jacobmealey/capstone/hardware/models/assembly.FCStd

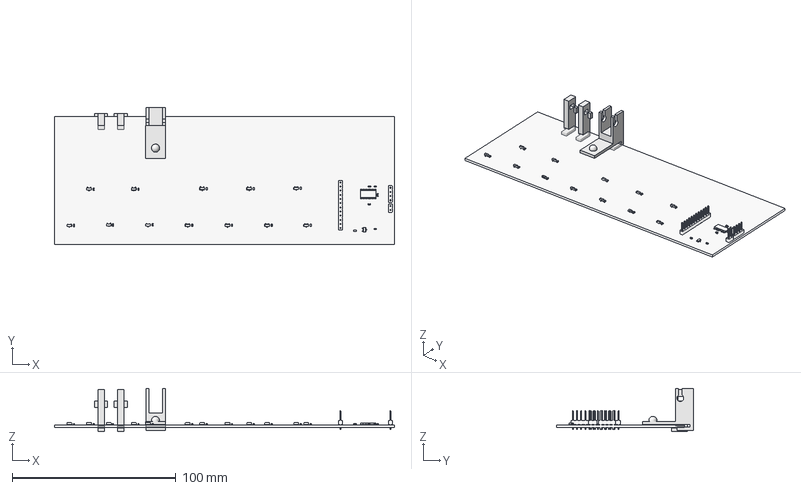
[picture p1: CAD file, 2022-12-01]
hardware/models/assembly.FCStd
207.5 x 83.5 x 26.2 mm
developmentboard
key_mount-Body
key_mount-Body001
