jacobmealey/capstone/hardware/STL/widekey_littleassembly.FCStd

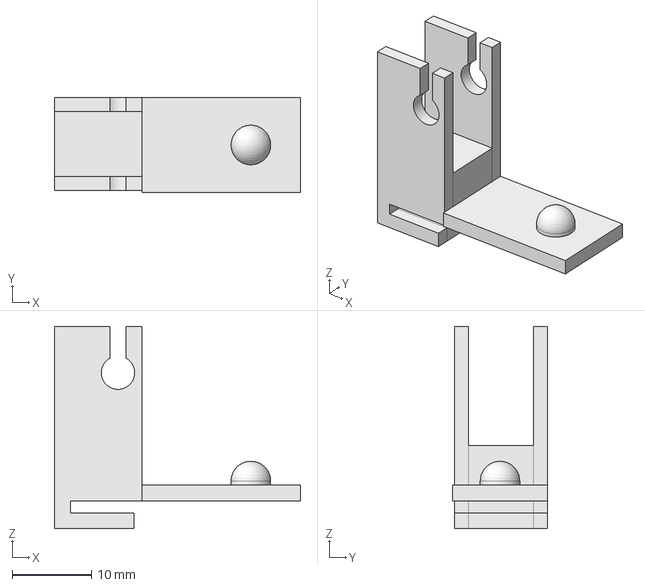
[picture p2: CAD file, 2022-12-01]
hardware/STL/widekey_littleassembly.FCStd
31.0 x 12.0 x 25.5 mm
