jacobmealey/capstone/hardware/STL/key_1-AssemblyFillet.stl

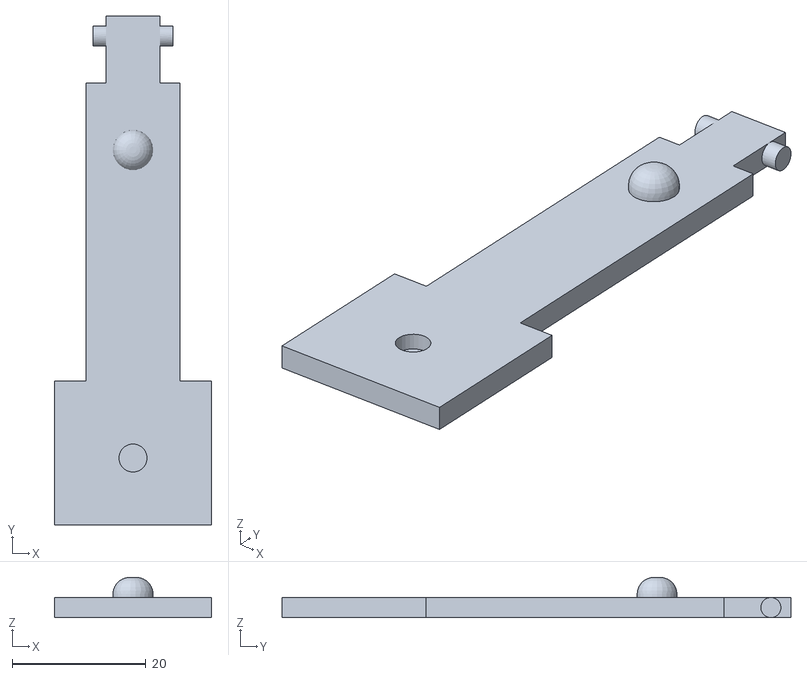
[picture p3: CAD file, 2022-08-15]
hardware/STL/key_1-AssemblyFillet.stl
23.5 x 76.0 x 6.00
