jacobmealey/capstone/hardware/models/key_2.FCStd

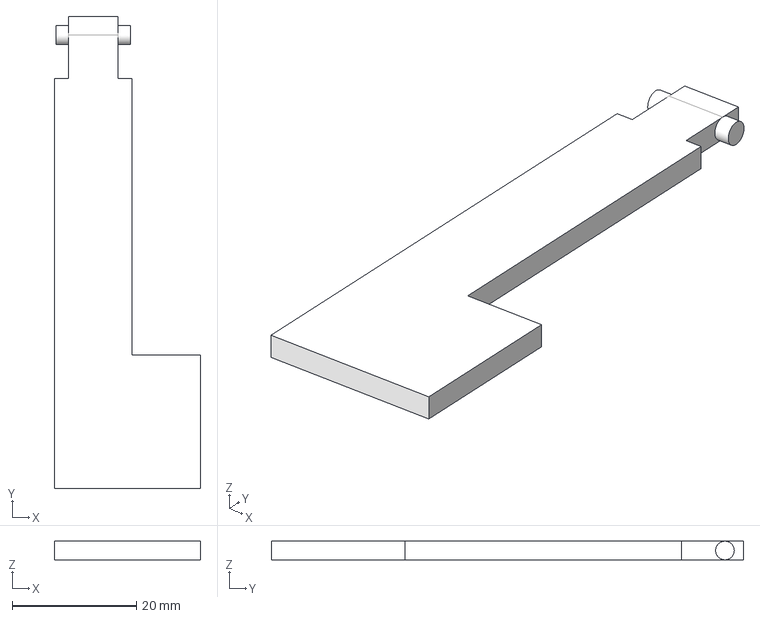
[picture p4: CAD file, 2022-12-01]
hardware/models/key_2.FCStd
23.5 x 76.0 x 3.00 mm
