jacobmealey/capstone/hardware/models/key_spring_mount.FCStd

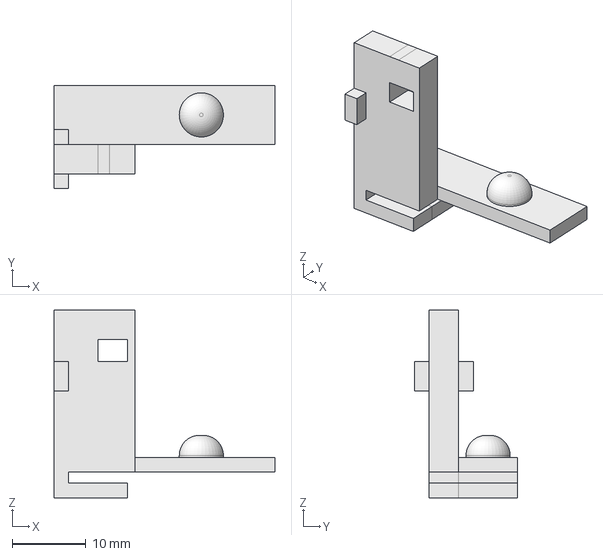
[picture p5: CAD file, 2022-11-03]
hardware/models/key_spring_mount.FCStd
30.0 x 14.0 x 25.5 mm
