jacobmealey/capstone/hardware/models/key_black.FCStd

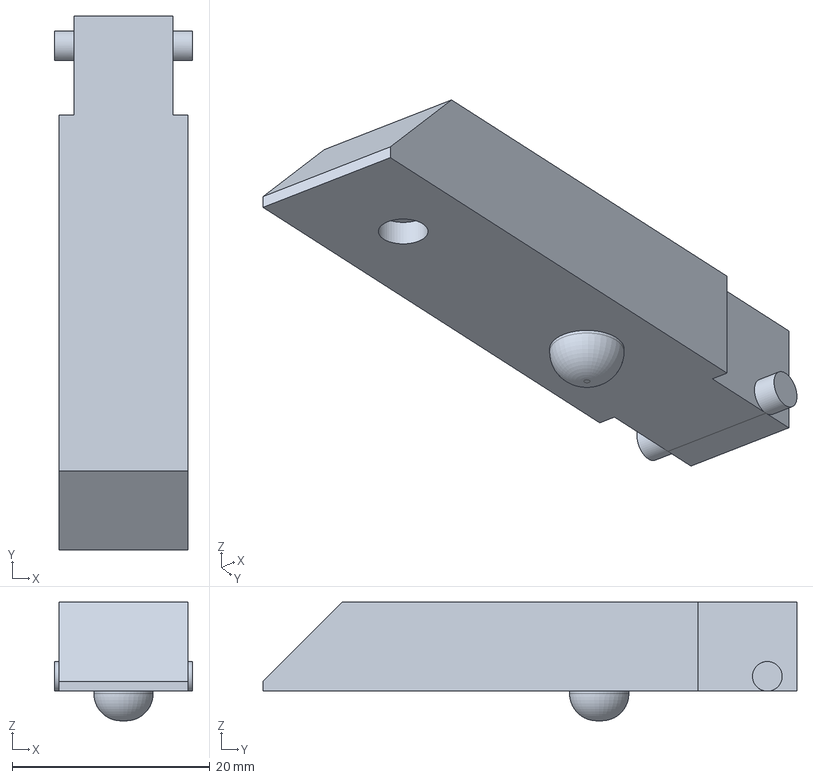
[picture p6: CAD file, 2022-11-03]
hardware/models/key_black.FCStd
14.0 x 54.0 x 12.0 mm
