jacobmealey/capstone/hardware/models/key_3A.FCStd

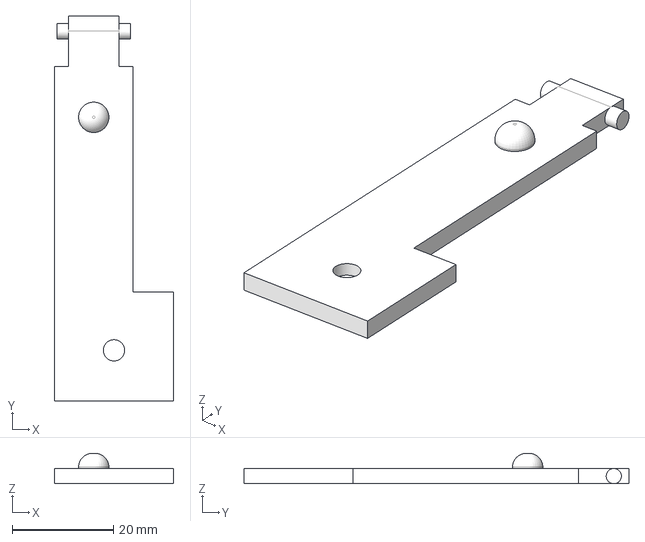
[picture p7: CAD file, 2022-08-15]
hardware/models/key_3A.FCStd
23.5 x 76.0 x 6.00 mm
