jacobmealey/capstone/hardware/models/key_1A.FCStd

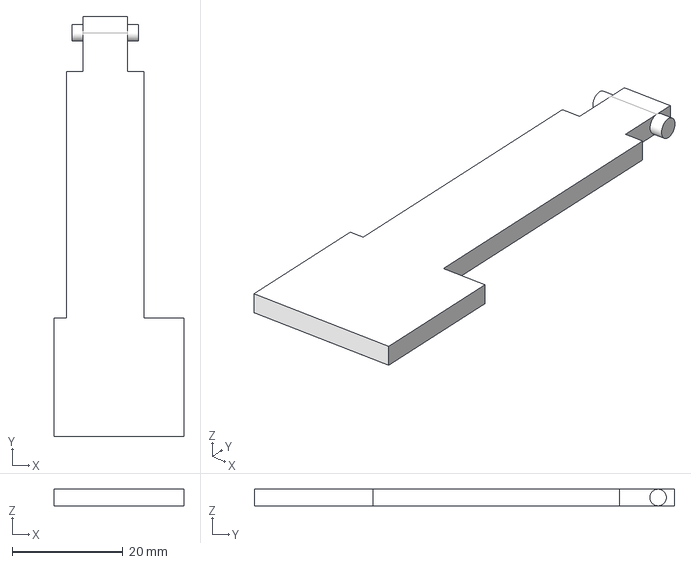
[picture p8: CAD file, 2022-08-15]
hardware/models/key_1A.FCStd
23.5 x 76.0 x 3.00 mm
