jacobmealey/capstone/hardware/STL/key_and_spring.stl

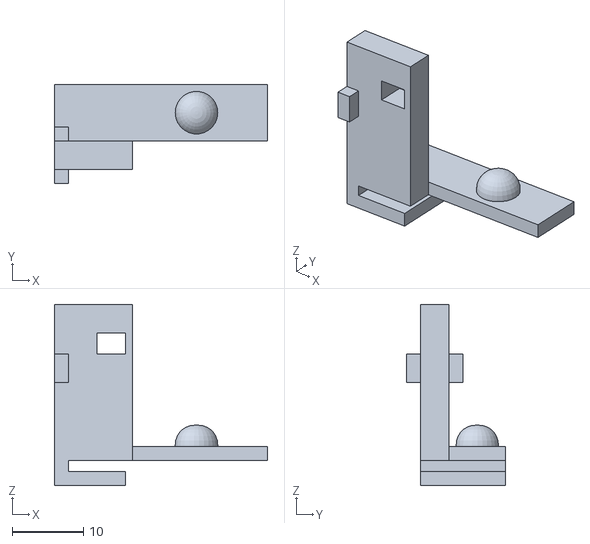
[picture p9: CAD file, 2022-11-03]
hardware/STL/key_and_spring.stl
30.0 x 14.0 x 25.5
