jacobmealey/capstone/hardware/STL/spring_mount-BodyFillet.stl

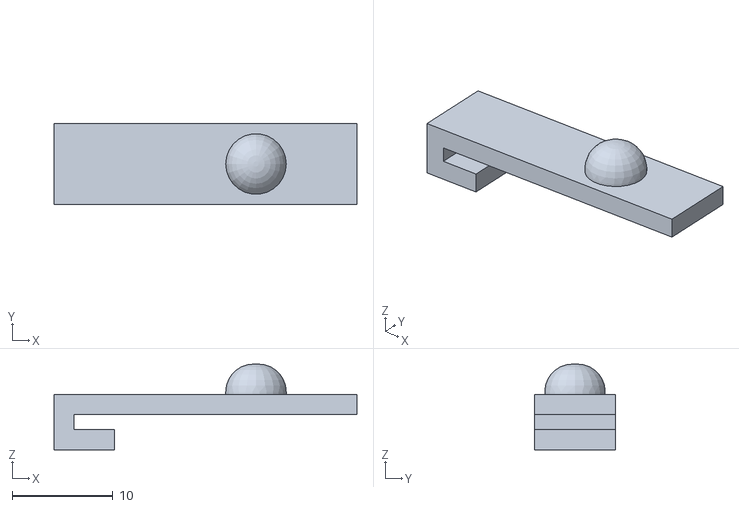
[picture p10: CAD file, 2022-08-15]
hardware/STL/spring_mount-BodyFillet.stl
30.0 x 8.00 x 8.50
