jacobmealey/capstone/hardware/models/key_3.FCStd

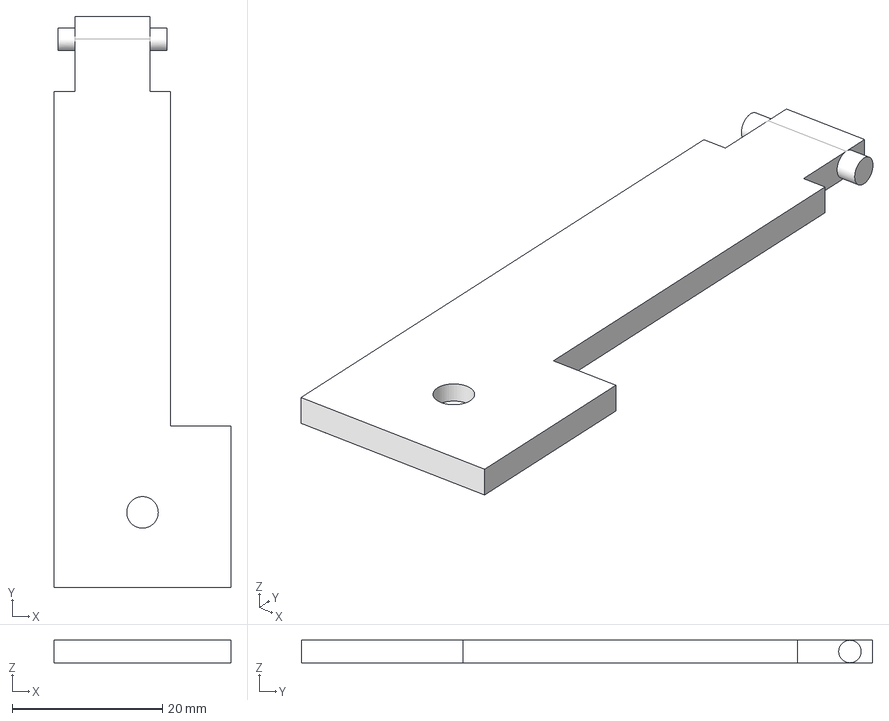
[picture p11: CAD file, 2022-08-15]
hardware/models/key_3.FCStd
23.5 x 76.0 x 3.00 mm
