jacobmealey/capstone/hardware/STL/key_mount-Body.stl

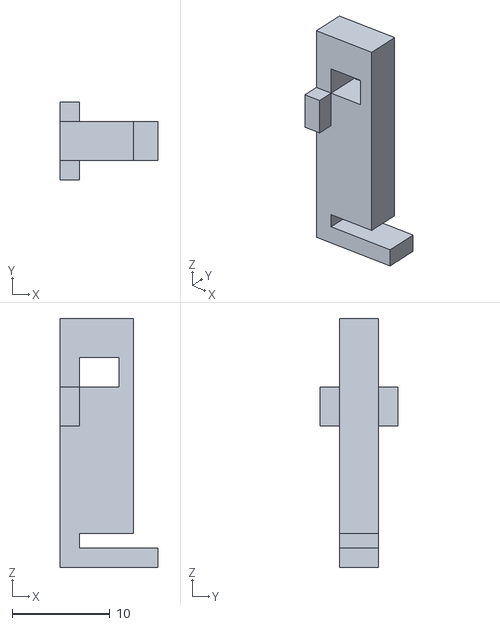
[picture p12: CAD file, 2022-08-15]
hardware/STL/key_mount-Body.stl
10.0 x 8.00 x 25.5
