jacobmealey/capstone/hardware/STL/key_2Bstl.stl

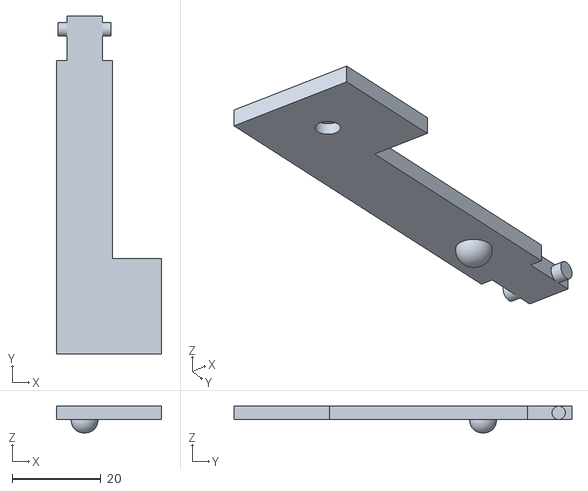
[picture p13: CAD file, 2022-08-15]
hardware/STL/key_2Bstl.stl
23.5 x 76.0 x 6.00
