jacobmealey/capstone/(list of files, cad)

Other CAD files:
hardware/STL/littleassembly.FCStd
hardware/STL/spring_mount-BodyFillet_wide.stl
hardware/STL/keyv2.stl
hardware/STL/keyspringmount_v2.stl
hardware/models/key_1A_A.FCStd
hardware/STL/key_black-key_black.stl
hardware/models/key_1.FCStd
hardware/models/key_3B.FCStd
hardware/models/key_2B.FCStd
hardware/models/key_2A.FCStd
hardware/models/key_mount.FCStd
hardware/models/spring_mount.FCStd
hardware/models/key_1A_B.FCStd
hardware/STL/key_1A_A.stl
hardware/STL/key_1A_B.stl
hardware/STL/key_2A.stl
hardware/STL/key_3A.stl
hardware/STL/key_3B.stl
hardware/STL/widekey_littleassembly.stl
hardware/models/key_and_spring.stl
