jacobmealey/capstone/hardware/powerboard/powerboard.kicad_pcb

## KiCad design hardware/powerboard/powerboard.kicad_pcb (2022-12-05)

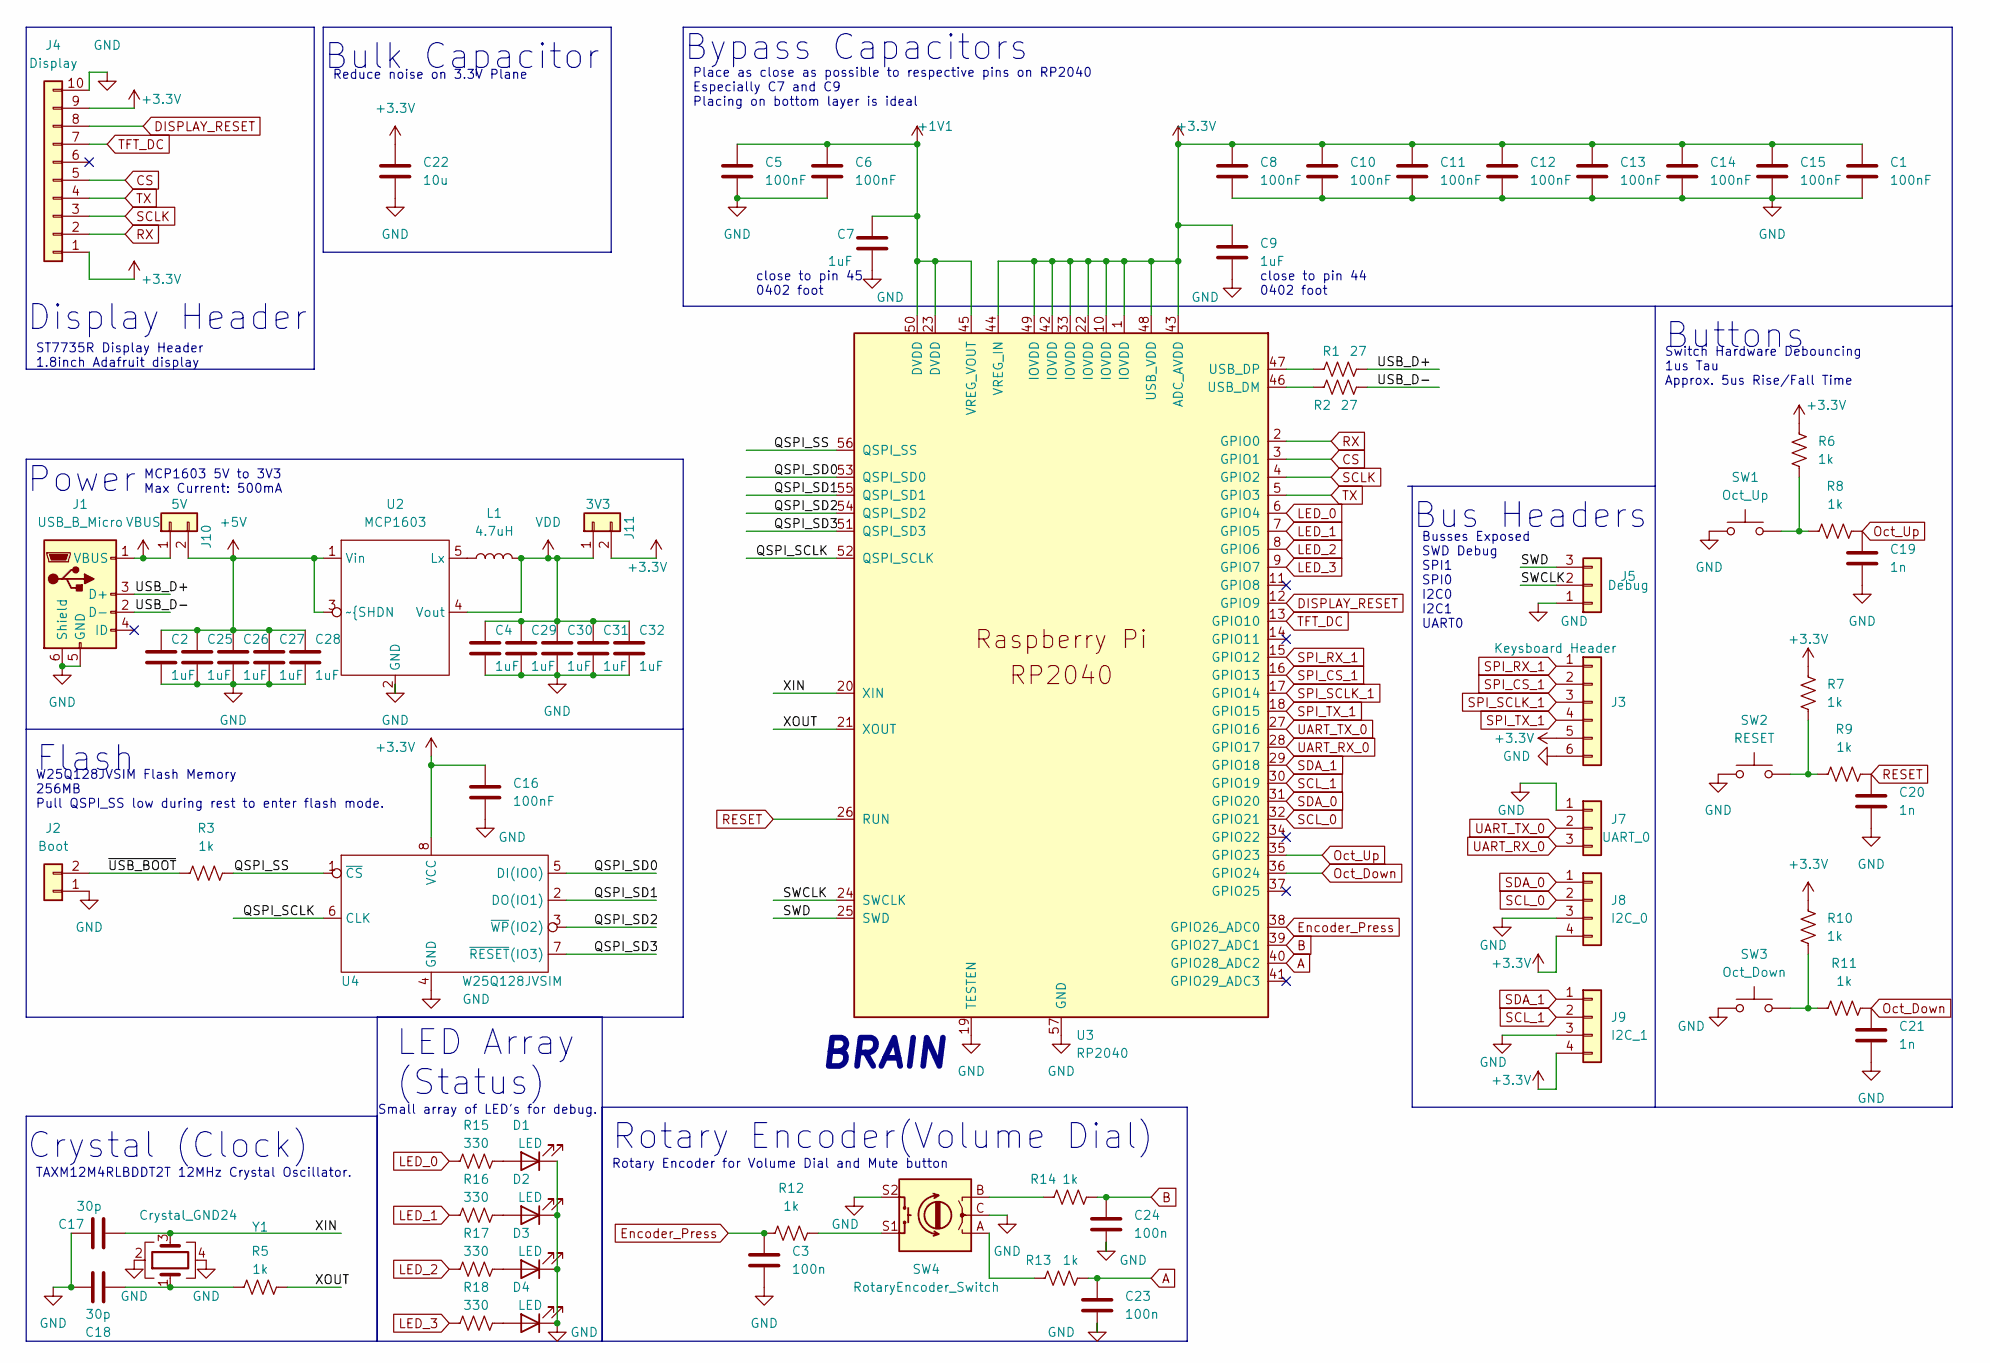
[picture p14: schematic powerboard.kicad_sch, MIDI Keyboard: Brain Board]

Parts:
C1, C5, C6, C8, C10, C11, C12, C13, C14, C15: 100nF; C_0402_1005Metric; LCSC C307331
C2, C4, C25, C26, C27, C28, C29, C30, C31, C32: 1uF; C_0805_2012Metric; LCSC C28323
C3, C23, C24: 100n; C_0402_1005Metric; LCSC C307331
C7, C9: 1uF; C_0402_1005Metric; LCSC C307413
C16: 100nF; C_0603_1608Metric; LCSC C307331
C17, C18: 30p; C_0603_1608Metric; LCSC C1658
C19, C20, C21: 1n; C_0603_1608Metric; LCSC C1588
C22: 10u; C_0805_2012Metric; LCSC C440198
D1, D2, D3, D4: LED; LED_0603_1608Metric; LCSC C87326
J1: USB_B_Micro; USB_Micro-B_Amphenol_10118194_Horizontal; LCSC C132563
J2: Boot; PinHeader_1x02_P2.54mm_Vertical; LCSC C2905434
J3: Keysboard Header; PinSocket_1x06_P2.54mm_Horizontal; LCSC C2932681
J4: Display; PinSocket_1x10_P2.54mm_Vertical; LCSC C2905418
J5: Debug; PinHeader_1x03_P2.54mm_Vertical; LCSC C2932698
J7: UART_0; PinHeader_1x03_P2.54mm_Vertical; LCSC C2932698
J8: I2C_0; PinHeader_1x04_P2.54mm_Vertical; LCSC C2905435
J9: I2C_1; PinHeader_1x04_P2.54mm_Vertical; LCSC C2905435
J10: 5V; PinHeader_1x02_P2.54mm_Vertical; LCSC C2905434
J11: 3V3; PinHeader_1x02_P2.54mm_Vertical; LCSC C2905434
L1: 4.7uH; L_1812_4532Metric; LCSC C701275
R1, R2: 27; R_0402_1005Metric; LCSC C25100
R3, R5, R6, R7, R8, R9, R10, R11, R12, R13, R14: 1k; R_0603_1608Metric; LCSC C21190
R15, R16, R17, R18: 330; R_0603_1608Metric; LCSC C23138
SW1: Oct_Up; SW_PUSH_6mm; LCSC C428628
SW2: RESET; SW_PUSH_6mm; LCSC C428628
SW3: Oct_Down; SW_PUSH_6mm; LCSC C428628
SW4: RotaryEncoder_Switch; RotaryEncoder_Alps_EC11E-Switch_Vertical_H20mm; LCSC C278348
U2: MCP1603; TSOT-23-5; LCSC C150803
U3: RP2040; RP2040-QFN-56; LCSC C9900024873
U4: W25Q128JVSIM; SOIC-8W_5.3x5.3mm_P1.27mm; LCSC C2613930
Y1: Crystal_GND24; Crystal_SMD_3225-4Pin_3.2x2.5mm; LCSC C133334

Connections:
+1V1: C5.1, C6.1, C7.1, U3.23 (DVDD), U3.45 (VREG_VOUT), U3.50 (DVDD)
+3.3V: C1.1, C8.1, C9.1, C10.1, C11.1, C12.1, C13.1, C14.1, C15.1, C16.1, C22.1, J3.5, J4.1, J4.9, J8.4, J9.4, J11.2, R6.1, R7.1, R10.1, U3.1 (IOVDD), U3.10 (IOVDD), U3.22 (IOVDD), U3.33 (IOVDD), U3.42 (IOVDD), U3.43 (ADC_AVDD), U3.44 (VREG_IN), U3.48 (USB_VDD), U3.49 (IOVDD), U4.8 (VCC)
+5V: C2.1, C25.1, C26.1, C27.1, C28.1, J10.2, U2.1 (Vin), U2.3 (~{SHDN)
/QSPI_SCLK: U3.52 (QSPI_SCLK), U4.6 (CLK)
/QSPI_SD0: U3.53 (QSPI_SD0), U4.5 (DI(IO0))
/QSPI_SD1: U3.55 (QSPI_SD1), U4.2 (DO(IO1))
/QSPI_SD2: U3.54 (QSPI_SD2), U4.3 (~WP(IO2))
/QSPI_SD3: U3.51 (QSPI_SD3), U4.7 (~RESET(IO3))
/QSPI_SS: R3.2, U3.56 (QSPI_SS), U4.1 (~CS)
/SWCLK: J5.2, U3.24 (SWCLK)
/SWD: J5.3, U3.25 (SWD)
/USB_D+: J1.3 (D+), R1.2
/USB_D-: J1.2 (D-), R2.2
/XIN: C17.2, U3.20 (XIN), Y1.3
/XOUT: R5.2, U3.21 (XOUT)
/~USB_BOOT: J2.2, R3.1
A: C23.1, R13.2, U3.40 (GPIO28_ADC2)
B: C24.1, R14.2, U3.39 (GPIO27_ADC1)
CS: J4.5, U3.3 (GPIO1)
DISPLAY_RESET: J4.8, U3.12 (GPIO9)
Encoder_Press: C3.1, R12.1, U3.38 (GPIO26_ADC0)
GND: C1.2, C2.2, C3.2, C4.2, C5.2, C6.2, C7.2, C8.2, C9.2, C10.2, C11.2, C12.2, C13.2, C14.2, C15.2, C16.2, C17.1, C18.1, C19.2, C20.2, C21.2, C22.2, C23.2, C24.2, C25.2, C26.2, C27.2, C28.2, C29.2, C30.2, C31.2, C32.2, D1.1 (K), D2.1 (K), D3.1 (K), D4.1 (K), J1.5 (GND), J1.6 (Shield), J2.1, J3.6, J4.10, J5.1, J7.1, J8.3, J9.3, SW1.1, SW2.1, SW3.1, SW4.C, SW4.S2, U2.2 (GND), U3.19 (TESTEN), U3.57 (GND), U4.4 (GND), Y1.2, Y1.4
LED_0: R15.1, U3.6 (GPIO4)
LED_1: R16.1, U3.7 (GPIO5)
LED_2: R17.1, U3.8 (GPIO6)
LED_3: R18.1, U3.9 (GPIO7)
unnamed: C18.2, R5.1, Y1.1
unnamed: D1.2 (A), R15.2
unnamed: D2.2 (A), R16.2
unnamed: D3.2 (A), R17.2
unnamed: D4.2 (A), R18.2
unnamed: L1.1, U2.5 (Lx)
unnamed: R1.1, U3.47 (USB_DP)
unnamed: R2.1, U3.46 (USB_DM)
unnamed: R6.2, R8.1, SW1.2
unnamed: R7.2, R9.1, SW2.2
unnamed: R10.2, R11.1, SW3.2
unnamed: R12.2, SW4.S1
unnamed: R13.1, SW4.A
unnamed: R14.1, SW4.B
Oct_Down: C21.1, R11.2, U3.36 (GPIO24)
Oct_Up: C19.1, R8.2, U3.35 (GPIO23)
RESET: C20.1, R9.2, U3.26 (RUN)
RX: J4.2, U3.2 (GPIO0)
SCLK: J4.3, U3.4 (GPIO2)
SCL_0: J8.2, U3.32 (GPIO21)
SCL_1: J9.2, U3.30 (GPIO19)
SDA_0: J8.1, U3.31 (GPIO20)
SDA_1: J9.1, U3.29 (GPIO18)
SPI_CS_1: J3.2, U3.16 (GPIO13)
SPI_RX_1: J3.1, U3.15 (GPIO12)
SPI_SCLK_1: J3.3, U3.17 (GPIO14)
SPI_TX_1: J3.4, U3.18 (GPIO15)
TFT_DC: J4.7, U3.13 (GPIO10)
TX: J4.4, U3.5 (GPIO3)
UART_RX_0: J7.3, U3.28 (GPIO17)
UART_TX_0: J7.2, U3.27 (GPIO16)
VBUS: J1.1 (VBUS), J10.1
VDD: C4.1, C29.1, C30.1, C31.1, C32.1, J11.1, L1.2, U2.4 (Vout)

Notes on the sheet:
Power
Busses Exposed SWD Debug SPI1 SPI0 I2C0 I2C1 UART0
Small array of LED's for debug.
W25Q128JVSIM Flash Memory 256MB Pull QSPI_SS low during rest to enter flash mode.
Bus Headers
Rotary Encoder for Volume Dial and Mute button
Buttons
Flash
Display Header
LED Array (Status)
Bypass Capacitors
BRAIN
TAXM12M4RLBDDT2T 12MHz Crystal Oscillator.
Crystal (Clock)
close to pin 44 0402 foot
Bulk Capacitor
close to pin 45 0402 foot
Place as close as possible to respective pins on RP2040 Especially C7 and C9 Placing on bottom layer is ideal
MCP1603 5V to 3V3 Max Current: 500mA
Reduce noise on 3.3V Plane
ST7735R Display Header 1.8inch Adafruit display
Rotary Encoder(Volume Dial)
Switch Hardware Debouncing 1us Tau Approx. 5us Rise/Fall Time

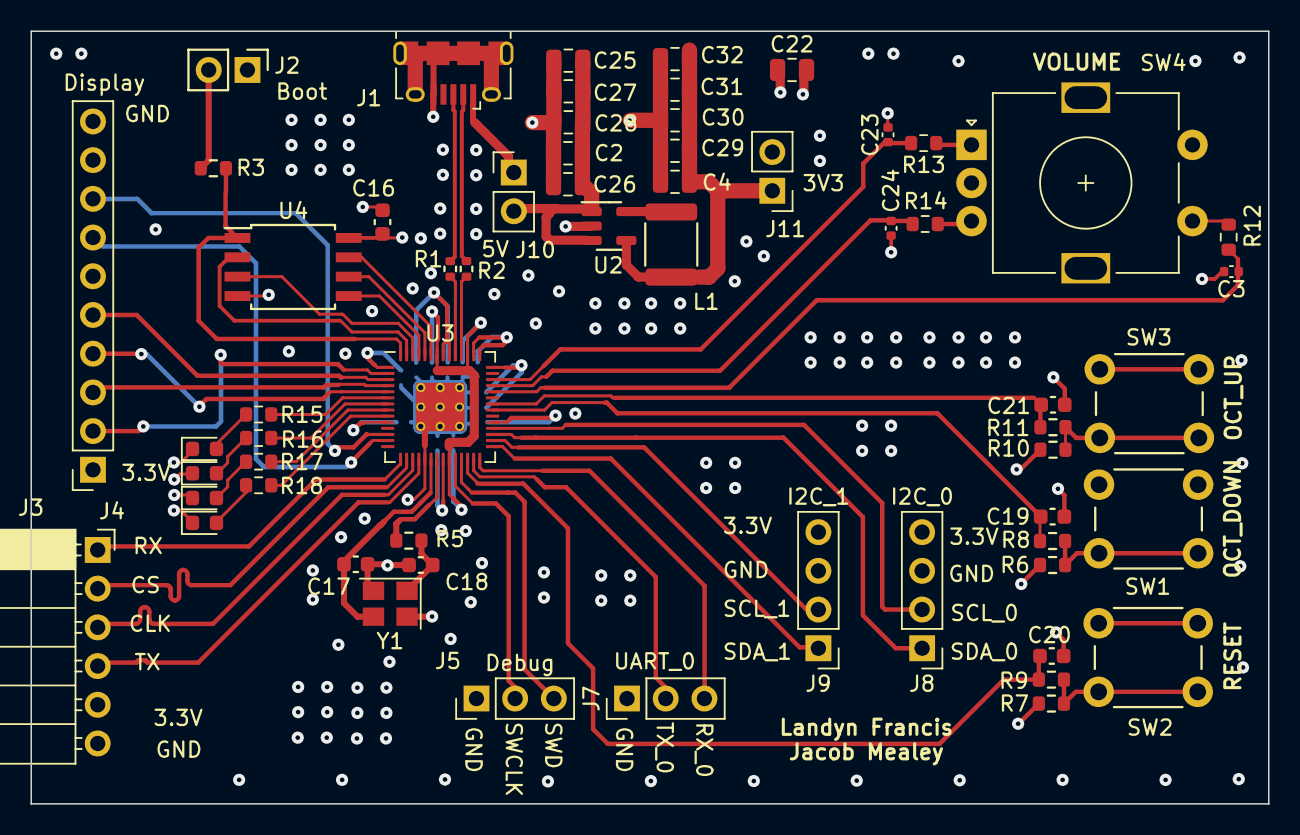
[picture p15: board powerboard.kicad_pcb from above]

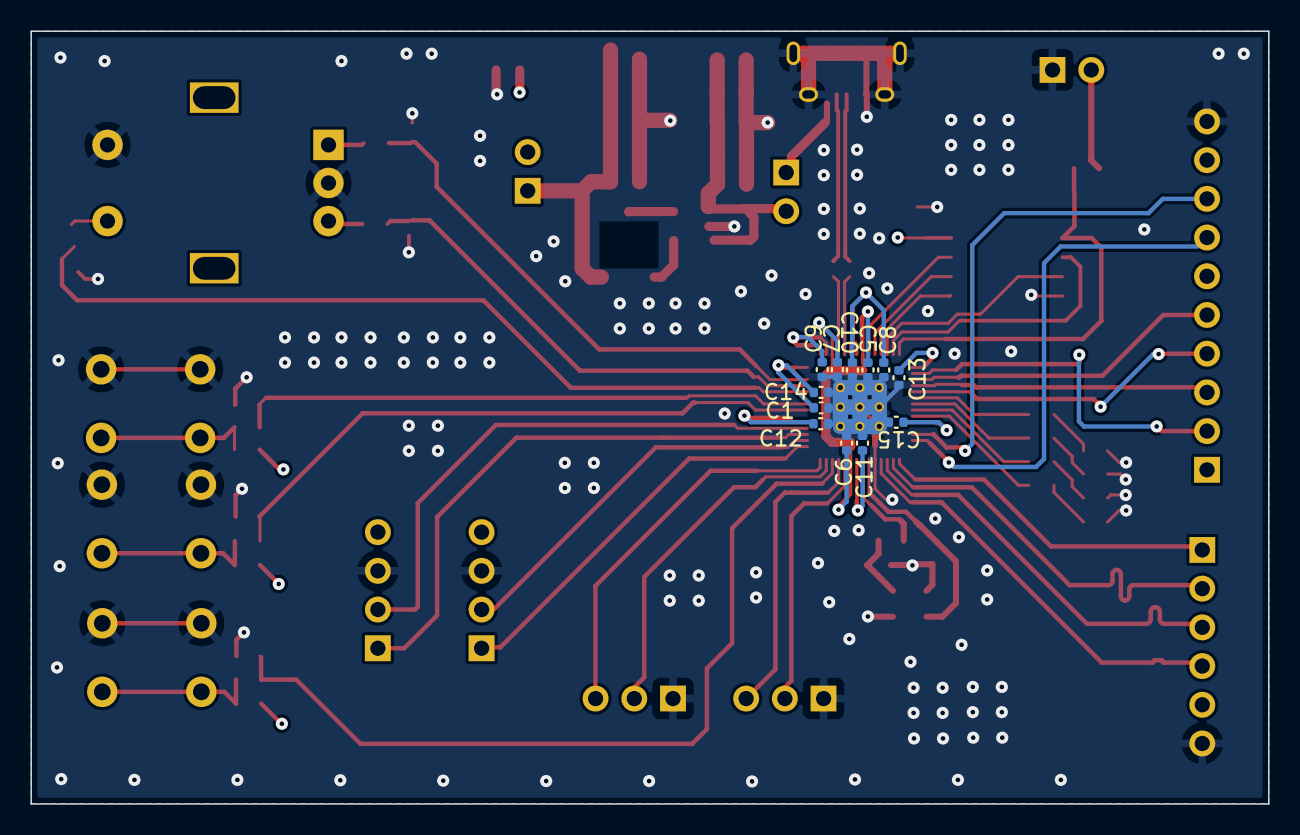
[picture p16: board powerboard.kicad_pcb from below]

Board: 4 copper layers, 81.2 x 50.7 mm, 72 parts (12 on the bottom side), 59 nets.
