jacobmealey/capstone/hardware/developmentboard/developmentboard.kicad_pcb

## KiCad design hardware/developmentboard/developmentboard.kicad_pcb (2022-10-17)

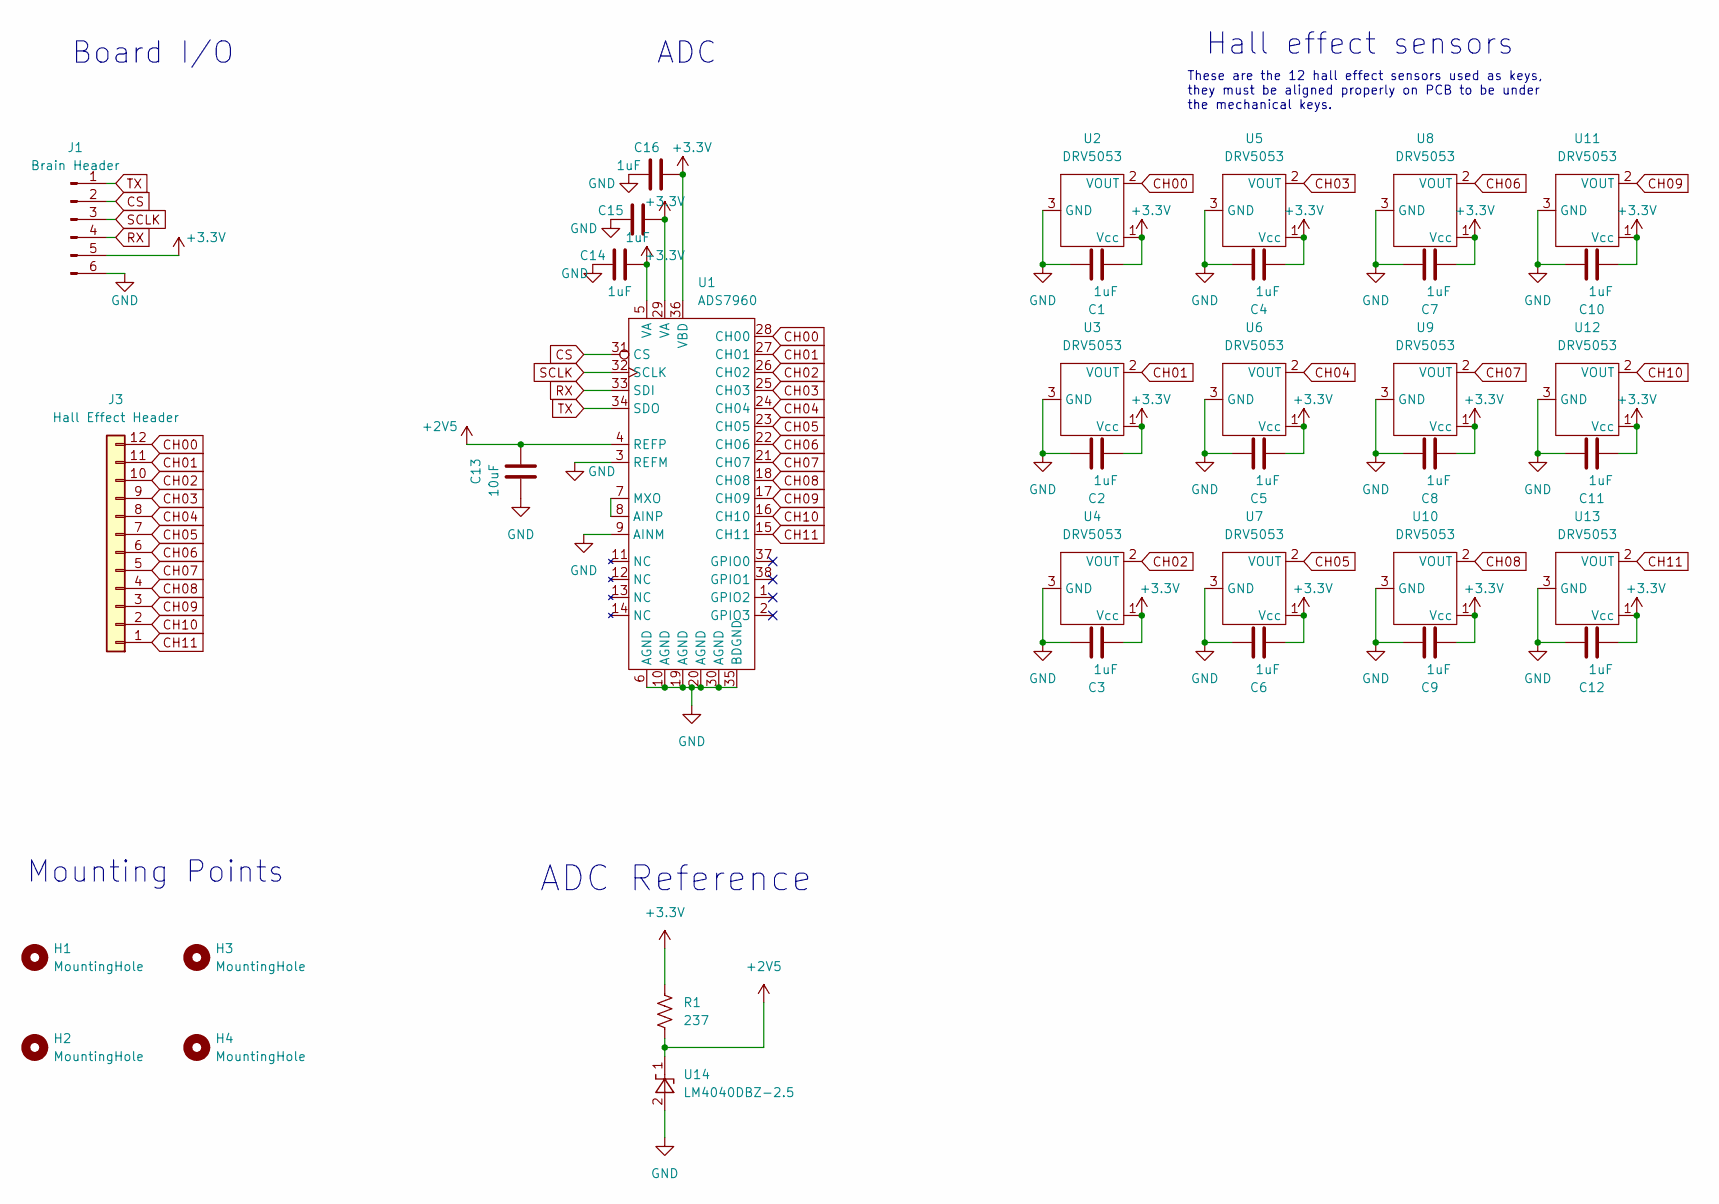
[picture p17: schematic developmentboard.kicad_sch, MIDI Keyboard: Keyboard]

Parts:
C1, C2, C3, C4, C5, C6, C7, C8, C9, C10, C11, C12, C14, C15, C16: 1uF; C_0603_1608Metric; LCSC C90540
C13: 10uF; C_0603_1608Metric; LCSC C96446
H1, H2, H3, H4: MountingHole; MountingHole_4.3mm_M4
J1: Brain Header; PinHeader_1x06_P2.54mm_Vertical; LCSC C2932681
J3: Hall Effect Header; PinHeader_1x12_P2.54mm_Vertical; LCSC C2833334
R1: 237; R_1210_3225Metric; part number CR1210F237RP05Z; LCSC C174455
U1: ADS7960; TSSOP-38_4.4x9.7mm_P0.5mm; LCSC C1543353
U2, U3, U4, U5, U6, U7, U8, U9, U10, U11, U12, U13: DRV5053; SOT-23; LCSC C2866569
U14: LM4040DBZ-2.5; SOT-23; LCSC C134019

Connections:
+2V5: C13.1, R1.2, U1.4 (REFP), U14.1 (K)
+3.3V: C1.2, C2.2, C3.2, C4.2, C5.2, C6.2, C7.2, C8.2, C9.2, C10.2, C11.2, C12.2, C14.2, C15.2, C16.2, J1.5, R1.1, U1.5 (VA), U1.29 (VA), U1.36 (VBD), U2.1 (Vcc), U3.1 (Vcc), U4.1 (Vcc), U5.1 (Vcc), U6.1 (Vcc), U7.1 (Vcc), U8.1 (Vcc), U9.1 (Vcc), U10.1 (Vcc), U11.1 (Vcc), U12.1 (Vcc), U13.1 (Vcc)
CH00: J3.12, U1.28 (CH00), U2.2 (VOUT)
CH01: J3.11, U1.27 (CH01), U3.2 (VOUT)
CH02: J3.10, U1.26 (CH02), U4.2 (VOUT)
CH03: J3.9, U1.25 (CH03), U5.2 (VOUT)
CH04: J3.8, U1.24 (CH04), U6.2 (VOUT)
CH05: J3.7, U1.23 (CH05), U7.2 (VOUT)
CH06: J3.6, U1.22 (CH06), U8.2 (VOUT)
CH07: J3.5, U1.21 (CH07), U9.2 (VOUT)
CH08: J3.4, U1.18 (CH08), U10.2 (VOUT)
CH09: J3.3, U1.17 (CH09), U11.2 (VOUT)
CH10: J3.2, U1.16 (CH10), U12.2 (VOUT)
CH11: J3.1, U1.15 (CH11), U13.2 (VOUT)
CS: J1.2, U1.31 (CS)
GND: C1.1, C2.1, C3.1, C4.1, C5.1, C6.1, C7.1, C8.1, C9.1, C10.1, C11.1, C12.1, C13.2, C14.1, C15.1, C16.1, J1.6, U1.3 (REFM), U1.6 (AGND), U1.9 (AINM), U1.10 (AGND), U1.19 (AGND), U1.20 (AGND), U1.30 (AGND), U1.35 (BDGND), U2.3 (GND), U3.3 (GND), U4.3 (GND), U5.3 (GND), U6.3 (GND), U7.3 (GND), U8.3 (GND), U9.3 (GND), U10.3 (GND), U11.3 (GND), U12.3 (GND), U13.3 (GND), U14.2 (A)
unnamed: U1.7 (MXO), U1.8 (AINP)
RX: J1.4, U1.33 (SDI)
SCLK: J1.3, U1.32 (SCLK)
TX: J1.1, U1.34 (SDO)

Notes on the sheet:
Board I/O
Hall effect sensors
ADC
Mounting Points
ADC Reference
These are the 12 hall effect sensors used as keys, they must be aligned properly on PCB to be under the mechanical keys.

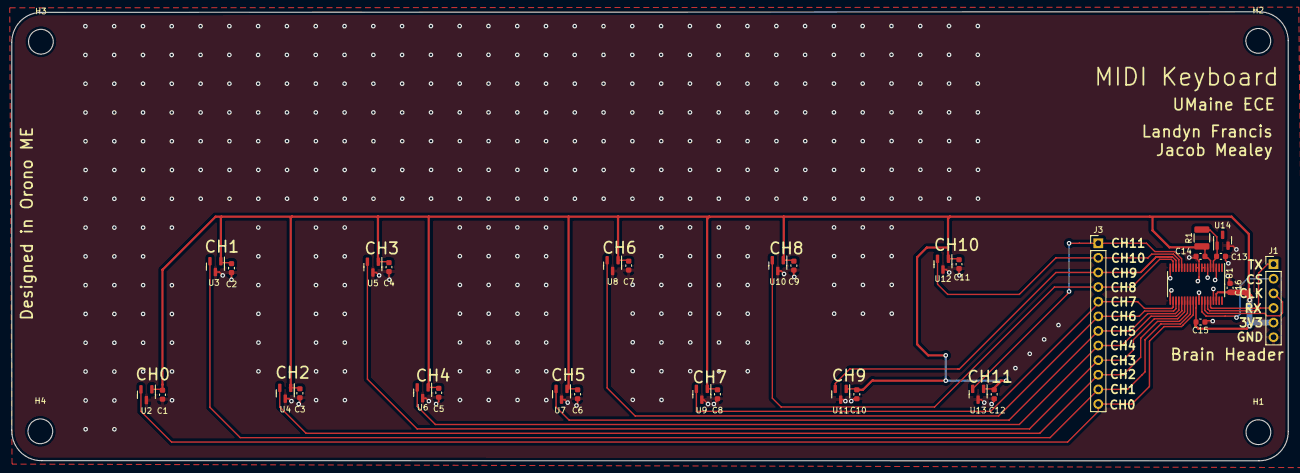
[picture p18: board developmentboard.kicad_pcb from above]

Board: 2 copper layers, 221.8 x 78.0 mm, 37 parts (0 on the bottom side), 20 nets.
