jacobmealey/capstone/software/firmware/midi_velocity_lut.h

#ifndef MIDI_VEL_LUT_H
#define MIDI_VEL_LUT_H

uint8_t midi_velocity_lut[95] = {
	0,
	1,
	2,
	4,
	5,
	6,
	8,
	9,
	10,
	12,
	13,
	14,
	16,
	17,
	18,
	20,
	21,
	22,
	24,
	25,
	26,
	28,
	29,
	30,
	32,
	33,
	34,
	36,
	37,
	38,
	40,
	41,
	42,
	44,
	45,
	46,
	48,
	49,
	50,
	52,
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
};

#endif
