jacobmealey/capstone/(commit log)

2022-07-16 ??? made a board lol
    [developmentboard.kicad_pcb, developmentboard.kicad_sch]
2022-07-22 added 2.5v regulator and 12 keys
    added 2.5v regulator and 12 keys
    added 2.5v regulator and 12 keys
    [developmentboard.kicad_pcb]
2022-07-31 migrated to version 6 made new symbols and included in repo
    [developmentboard.kicad_pcb, developmentboard.kicad_sch]
2022-07-31 made ece library parts relative to project
    forgit sym-lib-table
    [developmentboard.kicad_sch]
2022-07-31 added hall-effect sensor
    [developmentboard.kicad_sch]
2022-07-31 testing gitignore
    [developmentboard.kicad_sch]
2022-08-04 white keys going crazy
    [assembly.FCStd, key_1.FCStd, key_1A.FCStd, key_2.FCStd, key_3.FCStd, key_black.FCStd]
2022-08-04 colored keys finished basic assembly
    [assembly.FCStd, key_1.FCStd, key_1A.FCStd, key_2.FCStd, key_3.FCStd, key_black.FCStd]
2022-08-08 Development Board Schematic Changes
    [developmentboard.kicad_sch]
2022-08-09 3d models lol
    [assembly.FCStd, key_1A.FCStd, key_3.FCStd, key_mount.FCStd]
2022-08-12 Bypassed Va and Vbd to GND with 1uF AINM to GND Breakout pins for ADC pins
    [developmentboard.kicad_sch]
2022-08-15 finalized touches on keyyys + new key mounting
    finalized touches on keyyys + new key mounting
    [assembly.FCStd, key_1-AssemblyFillet.stl, key_1.FCStd, key_1A.FCStd, key_1A_A.FCStd, key_1A_A.stl, key_1A_B.FCStd, key_1A_B.stl]
2022-08-22 Powerboard schematic started
    [powerboard.kicad_pcb, powerboard.kicad_sch]
2022-08-26 scaffolding for pico project
2022-08-31 initial work for SPI ADC
2022-09-05 basic SPI working -- need to setup with DMA and timers
2022-09-07 Slight schematic changes
    [powerboard.kicad_sch]
2022-09-08 Schematic Headers Added, Footprints Updated
    [developmentboard.kicad_sch, powerboard.kicad_sch]
2022-09-09 Schematics updated, Layout started for powerboard
    [powerboard.kicad_pcb, powerboard.kicad_sch]
2022-09-09 Footprint library taken from RP2040 Minimal
2022-09-10 Powerboard PCB Started
    Powerboard PCB Started
    Placed and Routed Power Section, USB Port, Power Header, All Bypass Capacitors, USB Data Lines.
    [powerboard.kicad_pcb, powerboard.kicad_sch]
2022-09-11 More PCB Layout
    Board Overhauled
    Crystal Routed
    Bypass Caps on Bottom of Board
    Everything but switches done
    ANNULAR RING PROBLEM
    [powerboard.kicad_pcb, powerboard.kicad_sch]
2022-09-12 Power PCB: Everything(?!) Placed
    Added SPI_0 and SPI_1 Headers, for ADC and Display
    Added I2C_0 and I2C_1 Headers, for possible future peripherals, and/or 4 GPIO Pins.
    I assume we don't need UART for anything, so I left it un-routed.
    Everything placed I hope(?), just need to route the buttons and adjust copper zones.
    [powerboard.kicad_pcb, powerboard.kicad_sch]
2022-09-12 timer trigger spi write -- need interrupt for recieve
2022-09-12 added irq for receiving spi data
2022-09-12 PCB Adjustments
    [powerboard.kicad_pcb, powerboard.kicad_sch]
2022-09-12 Added global adc pointer to be shared among everything
2022-09-12 USB Header Footprint Changed
    Found a USB Header on JLCAssembly that has a matching footprint in KiCad, W
    [powerboard.kicad_pcb, powerboard.kicad_sch]
2022-09-13 manually looping through all channels! + uart for printing. need to get auto modes programmed in!
2022-09-13 auto mode 2 working correctly, cleaned up from last few days in hell
    [adc.c, adc.h]
2022-09-14 Power Board PCB: UART, LED's Smaller Crystal
    Replaced Old Crystal with 3N12000G33YC
    Added UART_0 with GP16 and GP17
    Added 4 LED's with 330OHM Resistors on GP4-GP7
    SPI Trace Widths 11.55 mil = 50Ohm Impedance
    [powerboard.kicad_pcb, powerboard.kicad_sch]
2022-09-15 cleaned up developmentboard
    [developmentboard.kicad_sch]
2022-09-15 Initial work on keys pcb
    ADC layout done and inline with the datasheet, and I arranged all the
    hall effect sensors.
    [developmentboard.kicad_pcb]
2022-09-15 Powerboard almsot done, need to finalize Power Circuit design
    [powerboard.kicad_pcb, powerboard.kicad_sch]
2022-09-15 layout for hall effect sensors, imported rules from powerboard
    [developmentboard.kicad_pcb]
2022-09-15 routing for keys and ground fill under adc
    [developmentboard.kicad_pcb]
2022-09-16 Pins.h added Pin assignments setup, SPI pins assigned in main.c
2022-09-16 Same as last commit? VS Code buggin
    [main.c]
2022-09-18 Powerboard changes
    [powerboard.kicad_pcb]
2022-09-18 board outline for developmentboard
    [developmentboard.kicad_pcb]
2022-09-18 fized DRC errors
    [developmentboard.kicad_pcb]
2022-09-18 added more to silkscreen
    [developmentboard.kicad_pcb]
2022-09-18 added more to silkscreen on developmentboard
    [developmentboard.kicad_pcb]
2022-09-19 Updated development board reference circuit
    I threw together a circuit based on the REF5025 datasheet to replace the LDO. This is the chip that is recommended on the ADC datasheet for the reference voltage. Available on JLC as REF5025AIDR
    [developmentboard.kicad_sch]
2022-09-19 added reference IC to PCB, removed LDO
    [assembly.FCStd, developmentboard.kicad_pcb, developmentboard.kicad_sch, key_black.FCStd]
2022-09-19 fixed logic for general_midi_send
    [adc.c, main.c, midi.c, midi.h]
2022-09-19 update adc to spi1 everywhere, fixed pin definitions
    [adc.c, adc.h, main.c, pins.h]
2022-09-19 more work on midi / adc interface
2022-09-20 finalized reference IC pcb stuffs - added footprints for bypass caps
    [developmentboard.kicad_pcb, developmentboard.kicad_sch]
2022-09-21 GPIO Functions done Small footprint changes to powerboard
    [powerboard.kicad_sch]
2022-09-21 Powerboard Renovations (Stage 1 of Finalization)
    Expand SPI 0 Header to match Display Header
    Confirm footprints for passives
    Power Circuit reorganized for short return paths
    Reset button now toggles RUN pin, does not connect to GPIO
    GPIO 10 connected to DISPLAY_RESET pin
    [powerboard.kicad_pcb, powerboard.kicad_sch]
2022-09-21 Power Measurement Headers
    Added, did not connect power measurement headers.
    Do we need these?
    How do we want to measure power?
    This is a high current, high frequency path, can we even do a header like this?
    [powerboard.kicad_sch]
2022-09-22 mounting holes for keys board
    [developmentboard.kicad_pcb]
2022-09-22 Powerboard Finalization
    Crystal Footprint and layout changed to match new crystal
    [powerboard.kicad_pcb, powerboard.kicad_sch]
2022-09-22 Powerboard review with sheaff
    [powerboard.kicad_pcb, powerboard.kicad_sch]
2022-09-22 made development board wider, changed reference voltage to use shunt regulator
    [developmentboard.kicad_pcb, developmentboard.kicad_sch]
2022-09-22 Powerboard PCB Revisions
    Expanded I2C Headers to include 3.3V and GND
    Expanded UART Header to include GND
    Expanded SWD Header to include GND
    Added Silkscreen for All(?) Parts
    Added GND Fill on Back Layer
    Added header for 3.3V and 5V Current Measurements
    Powerboard has all parts picked out and ready to order on JLC
    [powerboard.kicad_pcb, powerboard.kicad_sch]
2022-09-23 more adjustments on powerboard
    [powerboard.kicad_pcb]
2022-09-23 JLC Capabilities Double Checked
    Confirmed JLC Capabilities with Design Rules
    CHECK SILKSCREEN RULES
    [powerboard.kicad_pcb, powerboard.kicad_sch]
2022-09-23 More powerboard finalization
    [powerboard.kicad_pcb]
2022-09-23 Devboard and Powerboard matching headers lined up
    [developmentboard.kicad_pcb]
2022-09-26 MIDI Messages now only sent on Keypress
    [powerboard.kicad_pcb, powerboard.kicad_sch]
2022-09-27 GPIO Added for TFT_DC Display Pin
    Connected GPIO 10 to TFT_DC Pin on Display Header
    DISPLAY_RESET is now Connected to GPIO 9
    pins.h updated accordingly
    [powerboard.kicad_pcb, powerboard.kicad_sch]
2022-09-27 powerboard adjustments, bom added
    [powerboard.csv, powerboard.kicad_pcb, powerboard.kicad_sch]
2022-09-28 Powerboard Output Files Pt.1
    [powerboard.kicad_pcb, powerboard.kicad_sch]
2022-09-29 Tracked gerber files for powerboard
    [powerboard-B_Cu.gbl, powerboard-B_Mask.gbs, powerboard-B_Paste.gbp, powerboard-B_Silkscreen.gbo, powerboard-Edge_Cuts.gm1, powerboard-F_Cu.gtl, powerboard-F_Mask.gts, powerboard-F_Paste.gtp]
2022-09-29 boards board boards no more 3v3 plane and stuwutching
    [developmentboard.kicad_pcb, developmentboard.kicad_sch]
2022-09-29 Gerbers and pick and place generated
    [developmentboard.kicad_sch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]
2022-09-29 Footprint adjusted for W25QJVSIM FLASH
    [powerboard.csv, powerboard.kicad_pcb, powerboard.kicad_sch]
2022-09-29 File Cleanup
    Folder tracking makes me frown
    [powerboard-B_Cu.gbl, powerboard-B_Mask.gbs, powerboard-B_Paste.gbp, powerboard-B_Silkscreen.gbo, powerboard-Edge_Cuts.gm1, powerboard-F_Cu.gtl, powerboard-F_Mask.gts, powerboard-F_Paste.gtp]
2022-09-29 Trying to finalize Powerboard PCB
    JLC is being bitchy about the RP2040 and MCP1603, the parts aren't showing up in the part viewer preview window and they are "unselected" for assembly because "coordinate data cannot be found". Very worrying. but as detailed in my message on Discord, I think I have a solution.
    [powerboard-B_Cu.gbl, powerboard-B_Mask.gbs, powerboard-B_Paste.gbp, powerboard-B_Silkscreen.gbo, powerboard-Edge_Cuts.gm1, powerboard-F_Cu.gtl, powerboard-F_Mask.gts, powerboard-F_Paste.gtp]
2022-09-30 reworked things on develpoment
    [developmentboard.kicad_pcb, developmentboard.kicad_sch]
2022-10-03 GND Vias and RP2040 Footprint change
    When JLC was acting weird, I changed the footprint of the RP2040 to the generic version without thermal vias. I now want the thermal vias again, as they provide an easy GND connection for the chip.
    [powerboard.kicad_pcb, powerboard.kicad_sch]
2022-10-03 RP2040 Footprint Reset - See last commit
    [developmentboard-B_Cu.gbl, developmentboard-B_Mask.gbs, developmentboard-B_Paste.gbp, developmentboard-B_Silkscreen.gbo, developmentboard-Edge_Cuts.gm1, developmentboard-F_Cu.gtl, developmentboard-F_Mask.gts, developmentboard-F_Paste.gtp]
2022-10-05 Key current and prev values should be setup?
    [developmentboard-B_Cu.gbl, developmentboard-B_Mask.gbs, developmentboard-B_Paste.gbp, developmentboard-B_Silkscreen.gbo, developmentboard-Edge_Cuts.gm1, developmentboard-F_Cu.gtl, developmentboard-F_Mask.gts, developmentboard-F_Paste.gtp]
2022-10-05 changed speed of SPI
2022-10-06 working on ADC and Key integration.
2022-10-06 BIG UPDATE ADC now runs at 200kHz ADC Timer reduced to 60ms No more multi note on's when holding key down MIDI Velocity calculated, currently (49-123) range read_irq() function adjusted Probably need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
2022-10-12 Starting work on Rotary Encoder
2022-10-12 Rotary Encoder GPIO Code almost works... Interrupts are making it weird...
2022-10-12 Rotary Encoder logic should be correct. I think the A and B lines are bouncy Getting multiple interrupts on a single falling edge. Software debouncing not working...
    [gpio.c]
2022-10-13 Powerboard Tweaks
    Removed unnecessary header pin vias (lol)
    Adjusted traces
    Cleaned up Bypass Capacitor traces and vias on RP2040
    [powerboard.kicad_pcb]
2022-10-13 Still experiencing double interrupts on A and B lines Sometimes on other lines too, but not as bad... Debouncing hardware didn't fix the problem, definitely seems to be a software issue.
    [gpio.c, midi.c]
2022-10-13 Powerboard Fixes
    Rotary Encoder debouncing hardware fixed (it used to just be a pull up resistor and bypass cap, lol)
    Spaced out GPIO lines as best as I could.
    [powerboard.kicad_pcb, powerboard.kicad_sch]
2022-10-13 THICK TRACES
    I went through and replaced 0.2mm traces with 0.293mm traces, for a few reasons.
    1) Thicker = More current, just in case.
    2) This 0.293mm value is impedance matched for 50Ohms (Phil's Lab Video said it's generally a good idea)
    I also gave the power section very very thick traces. I figured why not, it's high frequency stuff, might as well have good thick traces.
    Still passes DRC
    [powerboard.kicad_pcb]
2022-10-13 THICKY TRACES
    THICK BOY TRACES GO BRRRRR
    [powerboard.kicad_pcb]
2022-10-14 Last Thicky Update
    More thickening
    [powerboard.kicad_pcb]
2022-10-14 3.3V Header Fix
    Both sides of the 3.3V header were on the same +3.3V net, this means that the copper fill on Layer 3 would have connected the header, not the jumper we plan to use. This would have likely broken one of our multimeters if we left it unchanged, and would make power measurements near impossible. The new power net on the output of the DCDC converter is VDD, which goes to one side of the 3.3V pin header, and the +3.3V net is on the other side.
    [powerboard.kicad_pcb, powerboard.kicad_sch]
2022-10-14 More trace spacing
    [powerboard.kicad_pcb]
2022-10-17 output file changes AND notes! Octave is now limited between 9 2 which corresponds to a piano range of C8 to C1, there are 3 notes below C1, that we will not be able to produce.
    [developmentboard-B_Cu.gbl, developmentboard-B_Mask.gbs, developmentboard-B_Paste.gbp, developmentboard-B_Silkscreen.gbo, developmentboard-Edge_Cuts.gm1, developmentboard-F_Cu.gtl, developmentboard-F_Mask.gts, developmentboard-F_Paste.gtp]
2022-10-26 ADC interrupt cleaned up MIDI signal code moved to main loop keyboard_task() function written
2022-11-01 Removed RESET GPIO predefine, Our RESET line is implemented through toggling the run pin. This happens through a hardware button. Independent of software.
    [pins.h]
2022-11-01 REV1 PCB
    [powerboard.kicad_sch]
2022-11-02 Everything but Keysboard and Display tested.
    [powerboard.kicad_pcb]
2022-11-02 Powerboard REV2 - R4 Removed
    [powerboard.kicad_pcb, powerboard.kicad_sch]
2022-11-03 SPI_1 Pin error fixed
    I'm a goof. The pins were off by 1. Rev. 1 will work with some additional wires. Rev. 2 will be ordered on my dime
    [powerboard.kicad_pcb, powerboard.kicad_sch]
2022-11-03 ADC can be set to Auto2
2022-11-03 Brain Board can now read the keys and send a single MIDI signal for a keypress below the current threshold of 63. Currently tested with only a single key, multi-key tests tomorrow
2022-11-03 changes to 3d models based physical rev1 board
    [assembly.FCStd, key_and_spring.stl, key_black-key_black.stl, key_black.FCStd, key_spring_mount.FCStd]
2022-11-07 Display now works with Brain Board
2022-11-07 preliminary work on velocity code -- needs to be measured
    [assembly.FCStd]
2022-11-08 cleaned up adc irq - added scaffolding for new velocity technique i want to explore
2022-11-09 made key velocity logic more stable -- real world velocity looks better
2022-11-10 keys velocity seems to better! needs more testing but much closer to spec
2022-11-10 Rev.2 Boards Headers updated Male on Keysboard, Female on Brainboard
    [developmentboard.kicad_sch, powerboard.kicad_pcb, powerboard.kicad_sch]
2022-11-14 small bug fixes - correct delta t, clears out display GARBAGE
    [littleassembly.FCStd]
2022-11-15 POWERBOARD REV2
    Haha silkscreen fix for REV2
    OCT UP and OCT DOWN are fixed
    [powerboard.kicad_pcb]
2022-11-22 changed milliseconds to microseconds, still displays milliseconds
2022-12-01 finalized more 3d models -- widekey holder
    [assembly.FCStd, key_2.FCStd]
2022-12-01 speed changes for ADC
2022-12-02 WIP: multiple key velocity working, midi velocity broken
    [adc_pos.h, keys.c, keys.h, main.c]
2022-12-05 comments for adc.* display.*
2022-12-05 Commented Powerboard Schematic/Powerboard V2
    Added comments and organization to Powerboard Schematic.
    Output files are now generated for Powerboard V2
    [powerboard-B_Cu.gbl, powerboard-B_Mask.gbs, powerboard-B_Paste.gbp, powerboard-B_Silkscreen.gbo, powerboard-Edge_Cuts.gm1, powerboard-F_Cu.gtl, powerboard-F_Mask.gts, powerboard-F_Paste.gtp]
2022-12-05 cleanup and comments on keysboard schematic
    [developmentboard.kicad_sch]
2022-12-05 Schemmy Comment Fix
    [powerboard.kicad_sch]
2022-12-07 midi velocity fix started
    [keys.h, main.c]
2023-02-19 adjusted pins.h to reflect new pcb pinout :)
